t0mg/spectra-frame/doc/clamp.step

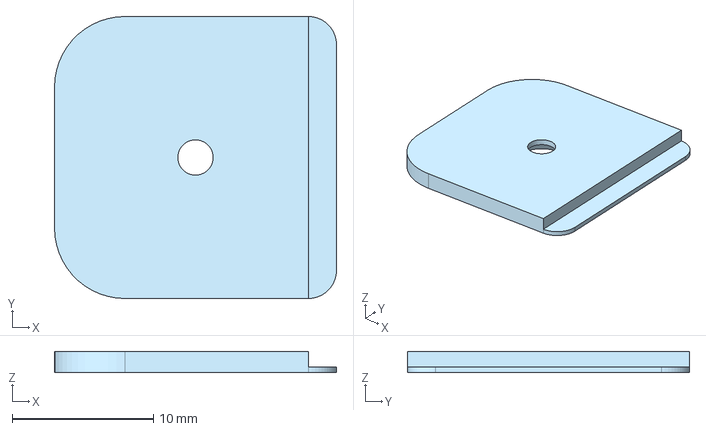
[picture p4: CAD file, 2025-06-17]
doc/clamp.step
20.0 x 20.0 x 1.50 mm
