t0mg/spectra-frame/(list of files, cad)

Other CAD files:
doc/clamp.stl
