t0mg/spectra-frame/src/DEV_Config.cpp

/*****************************************************************************
* | File      	:   DEV_Config.c
* | Author      :   Waveshare team
* | Function    :   Hardware underlying interface
* | Info        :
*----------------
* |	This version:   V1.0
* | Date        :   2020-02-19
* | Info        :
#
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
******************************************************************************/
#include <SPI.h>
#include "DEV_Config.h"

static const SPISettings epdSpiSettings(4000000, MSBFIRST, SPI_MODE0);

void GPIO_Config(void)
{
  pinMode(EPD_BUSY_PIN, INPUT); // No pull-up while HAT power is off
  pinMode(EPD_RST_PIN, OUTPUT);
  pinMode(EPD_DC_PIN, OUTPUT);
  pinMode(EPD_PWR_PIN, OUTPUT);
  pinMode(EPD_POW_EN_PIN, OUTPUT);

  pinMode(EPD_SCK_PIN, OUTPUT);
  pinMode(EPD_MOSI_PIN, OUTPUT);
  pinMode(EPD_CS_M_PIN, OUTPUT);
  pinMode(EPD_CS_S_PIN, OUTPUT);

  // Keep all lines LOW while TPS62827 (EPD_POW_EN_PIN) is OFF to prevent back-powering
  digitalWrite(EPD_CS_M_PIN, LOW);
  digitalWrite(EPD_CS_S_PIN, LOW);
  digitalWrite(EPD_DC_PIN, LOW);
  digitalWrite(EPD_RST_PIN, LOW);
  digitalWrite(EPD_SCK_PIN, LOW);
  digitalWrite(EPD_MOSI_PIN, LOW);
  digitalWrite(EPD_PWR_PIN, LOW);
  digitalWrite(EPD_POW_EN_PIN, LOW);

  // ProS3 LDO2 power-on (required for onboard LED and other peripherals)
  pinMode(LDO2_PIN, OUTPUT);
  digitalWrite(LDO2_PIN, HIGH);
}

void GPIO_Mode(UWORD GPIO_Pin, UWORD Mode)
{
  if (Mode == 0)
  {
    pinMode(GPIO_Pin, INPUT);
  }
  else
  {
    pinMode(GPIO_Pin, OUTPUT);
  }
}
/******************************************************************************
function:	Module Initialize, the BCM2835 library and initialize the pins, SPI 
protocol
parameter:
Info:
******************************************************************************/
UBYTE DEV_Module_Init(void)
{
  // Configure GPIO pins
  GPIO_Config();

  // Initialize serial communication for debugging
  Serial.begin(115200);

  SPI.begin(EPD_SCK_PIN, -1, EPD_MOSI_PIN, -1);

  return 0;
}

/******************************************************************************
function:
      SPI read and write
******************************************************************************/

void DEV_SPI_WriteByte(UBYTE data)
{
  SPI.beginTransaction(epdSpiSettings);
  SPI.transfer(data);
  SPI.endTransaction();
}

UBYTE DEV_SPI_ReadByte()
{
  UBYTE j = 0xff;
  GPIO_Mode(EPD_MOSI_PIN, 0);
  for (int i = 0; i < 8; i++)
  {
    j = j << 1;
    if (digitalRead(EPD_MOSI_PIN))
      j = j | 0x01;
    else
      j = j & 0xfe;

    digitalWrite(EPD_SCK_PIN, GPIO_PIN_SET);
    digitalWrite(EPD_SCK_PIN, GPIO_PIN_RESET);
  }
  GPIO_Mode(EPD_MOSI_PIN, 1);
  return j;
}

void DEV_SPI_Write_nByte(UBYTE *pData, UDOUBLE len)
{
  SPI.beginTransaction(epdSpiSettings);
  SPI.transferBytes(pData, NULL, len);
  SPI.endTransaction();
}

void DEV_Module_Exit(void)
{
  // gpio
  digitalWrite(EPD_PWR_PIN, LOW);
  digitalWrite(EPD_POW_EN_PIN, LOW);
  digitalWrite(EPD_RST_PIN, LOW);
}
