t0mg/spectra-frame/src/HibernationManager.cpp

#include "HibernationManager.h"
#include "Debug.h"
#include "EPD_13in3e.h" // For EPD_13IN3E_Sleep
#include "DEV_Config.h" // For DEV_Module_Exit
#include "driver/gpio.h"

#define HIBERNATION_MIN_TIMEOUT_MS 10000 // 10 secondes minimum

HibernationManager::HibernationManager(unsigned long timeoutMillis) {
    if (timeoutMillis < HIBERNATION_MIN_TIMEOUT_MS) {
        Debugf("Warning: inactivityTimeoutMillis too low (%lu ms), forced to %d ms\n", timeoutMillis, HIBERNATION_MIN_TIMEOUT_MS);
        inactivityTimeoutMillis = HIBERNATION_MIN_TIMEOUT_MS;
    } else {
        inactivityTimeoutMillis = timeoutMillis;
    }
    lastActivityTimeMillis = millis(); // Initialize with current time
    paused = false;
}

void HibernationManager::resetActivityTimer() {
    lastActivityTimeMillis = millis();
    Debugln("Hibernation: Activity timer reset.");
}

void HibernationManager::pause() {
    paused = true;
    Debugln("Hibernation: Timer paused.");
}

void HibernationManager::resumeAndReset() {
    paused = false;
    resetActivityTimer(); // Reset activity timer as resuming from a significant operation is an activity
    Debugln("Hibernation: Timer resumed and activity reset.");
}

bool HibernationManager::shouldGoToSleep() {
    if (paused) return false; // Don't go to sleep if paused
    unsigned long now = millis();
    unsigned long elapsed = now - lastActivityTimeMillis;
    Debugf("[HIBERNATION DEBUG] now=%lu, lastActivity=%lu, elapsed=%lu, timeout=%lu\n", now, lastActivityTimeMillis, elapsed, inactivityTimeoutMillis);
    if (elapsed > inactivityTimeoutMillis) {
        Debugln("Hibernation: Inactivity timeout reached.");
        return true;
    }
    return false;
}

void HibernationManager::goToDeepSleep() {
    Debugln("Hibernation: Preparing for deep sleep...");

    // Wait for E-Paper to be idle before sleeping (only if HAT is currently powered)
    if (DEV_Digital_Read(EPD_POW_EN_PIN) != 0) {
        Debug("Hibernation: Checking E-Paper busy status... ");
        uint32_t start = millis();
        while (!DEV_Digital_Read(EPD_BUSY_PIN) && (millis() - start < 5000)) { // LOW is busy
            Debug(".");
            delay(100);
        }
        Debugln(" E-Paper is idle.");
    }

    Debugln("Hibernation: Putting E-Paper to Sleep (EPD_13IN3E_Sleep)...");
    EPD_13IN3E_Sleep(); 

    Debugln("Hibernation: Exiting E-Paper Module (DEV_Module_Exit)...");
    DEV_Module_Exit(); 

    Debugln("Hibernation: Entering ESP32 deep sleep indefinitely.");
    #ifdef USE_DEBUG
    Serial.flush(); 
    #endif
    
    // Lock the Adafruit 4920 enable pin during deep sleep
    gpio_hold_en(EPD_POW_EN_PIN);
    gpio_pullup_dis(EPD_POW_EN_PIN);
    gpio_pulldown_en(EPD_POW_EN_PIN);
    gpio_deep_sleep_hold_en();
    
    esp_deep_sleep_start();
}

void HibernationManager::setInactivityTimeout(unsigned long timeoutMs) {
    if (timeoutMs < HIBERNATION_MIN_TIMEOUT_MS) {
        Debugf("Warning: inactivityTimeoutMillis too low (%lu ms), forced to %d ms\n", timeoutMs, HIBERNATION_MIN_TIMEOUT_MS);
        inactivityTimeoutMillis = HIBERNATION_MIN_TIMEOUT_MS;
    } else {
        inactivityTimeoutMillis = timeoutMs;
    }
    resetActivityTimer();
}

bool HibernationManager::isPaused() const {
    return paused;
}
