t0mg/spectra-frame/(commit log)

2025-06-17 first commit, gotta backup the stuff
    [partitions.csv]
2025-06-17 add lasercut.svg template
2025-06-17 add clamp stl+step 3d model
    [clamp.step, clamp.stl]
2026-02-10 migrate to ProS3 dev board
2026-02-13 Optimize power consumption by sequentializing display refresh
    Modified `EPD_13IN3E_TurnOnDisplay` to trigger the Master and Slave
    controllers sequentially rather than simultaneously. This reduces the
    peak power consumption spike during the physical refresh cycle of the
    13.3-inch e-paper display.
    - Added `EPD_13IN3E_ReadBusyH()` and stabilization delay between Master
    and Slave `DRF` commands.
    - Maintained simultaneous `PON` and `POF` for efficiency where power
    draw is lower.
2026-02-14 Add SEQUENTIAL_REFRESH build flag for power optimization
    Implemented a conditional sequential refresh mode for the 13.3-inch
    e-paper display, triggered by the `SEQUENTIAL_REFRESH` build flag.
    - Added `SEQUENTIAL_REFRESH` to `platformio.ini`.
    - Modified `EPD_13IN3E_TurnOnDisplay` in `src/EPD_13in3e.cpp` to use
    sequential refresh when the flag is defined, or the original
    simultaneous refresh otherwise.
    - Sequential mode reduces peak power consumption by refreshing the
    Master and Slave panels one after the other with stabilization
    delays.
2026-02-16 feat: move EPD power to GPIO 39 and add LED feedback during refresh
    - Moved display power control to GPIO 39 (Enable pin for external regulator).
    - Implemented power management in display driver (Init/Sleep cycles).
    - Added LED_MODE_EPD_POWERED for slow red pulse during display activation.
    - Updated DEV_Delay_ms to update LED during blocking hardware delays.
    - Fixed global LedManager pointer initialization and LDO2 power management.
    - Ensures the display is only powered when needed to prevent brownouts.
    [DEV_Config.cpp, DEV_Config.h, EPD_13in3e.cpp, LedManager.cpp, LedManager.h, main.cpp]
2026-02-16 feat: address PR feedback - revert DEV_Delay_ms and simplify LED mode
    - Reverted custom DEV_Delay_ms implementation in DEV_Config.
    - Removed LedManager dependency from DEV_Config.
    - Changed LED_MODE_EPD_POWERED to static red to avoid breathing during blocking delays.
    [DEV_Config.cpp, DEV_Config.h, LedManager.cpp]
2026-02-16 feat: revert global ledManager pointer as per PR feedback
    - Removed the global ledManager pointer and its initialization.
    - Re-cleaned the LedManager header and implementation.
    [LedManager.cpp, LedManager.h]
2026-02-16 Revert sequential refresh attempt
    [EPD_13in3e.cpp]
2026-02-16 use built in batt voltage of the pros3
2026-02-17 Update LedManager to support external monochrome LED with breathing patterns
    - Replaced onboard RGB LED logic with PWM-driven monochrome LED on GPIO 13.
    - Implemented a flexible breathing pattern utility function with configurable off, fade-in, on, and fade-out durations.
    - Updated all LedMode constants to map to appropriate monochrome breathing patterns.
    - Removed NeoPixel and ProS3 LDO2 dependencies from LedManager.
    [LedManager.cpp, LedManager.h]
2026-02-18 Update LedManager to support external monochrome LED via PWM on GPIO 13.
    - Removed NeoPixel dependency and ProS3 onboard LED logic.
    - Implemented breathing patterns using a time-based state machine and analogWrite().
    - Defined pattern parameters for IDLE, BUSY, ERROR, and STATIC modes.
    - Maintained LDO2 power in DEV_Config for board peripherals while decoupling LED control.
2026-02-18 display voltage measurement in web ui (wip)
2026-02-19 Initialize ums3 for ARDUINO_PROS3
2026-02-19 update laser template
2026-11-03 fix various bugs and issues with pros3 implementaton and separate buck converter to power the display
    [DEV_Config.cpp, EPD_13in3e.cpp, HibernationManager.cpp, WebServerManager.cpp, main.cpp]
